Dygmalab/raise-left/(commit log)

2017-09-06 matrices done, keys started laying out
    [raise-left.sch, rgb-matrix.sch]
2017-09-06 everything placed on the board
    [raise-left.kicad_pcb]
2017-09-06 remove usb
    [raise-left.sch]
2017-09-07 ready for integrated huble
    [raise-left.kicad_pcb, raise-left.sch]
2017-09-08 pre routing
    [raise-left.kicad_pcb, raise-left.sch]
2017-09-08 routed with leds
    [raise-left.kicad_pcb, raise-left.sch]
2017-09-08 proper outline, ready for fab
    [raise-left.kicad_pcb]
2017-09-08 sent to fab
    [raise-left.kicad_pcb]
2017-10-01 fix component values
    [raise-left.sch]
2017-10-01 fix polygon fills
    [raise-left.kicad_pcb]
2017-10-03 pre LED delete
    [palmled.sch, raise-left.sch]
2017-10-03 pre led layout
    [raise-left.kicad_pcb, raise-left.sch]
2017-10-03 led layout, pre routing
    [raise-left.kicad_pcb, raise-left.sch]
2017-10-04 led footprints
    [raise-left.kicad_pcb]
2017-10-04 new led footprint
    [raise-left.kicad_pcb, raise-left.sch]
2017-10-07 lp led pins done, excess leds removed
    [raise-left.kicad_pcb, raise-left.sch]
2017-10-07 led fp
2017-10-11 fab with 0.16 clearance
    [raise-left.kicad_pcb, raise-left.sch]
2017-10-13 component order codes
    [raise-left.kicad_pcb, raise-left.sch]
2017-11-07 v4.2 export
    [raise-left.kicad_pcb, raise-left.sch]
2017-11-15 farnell numbers
    [raise-left.sch]
2017-11-15 moved silk for cap
    [raise-left.kicad_pcb]
2017-12-11 silk screen led changes
    [raise-left.kicad_pcb]
2017-12-11 reduced size of 3528 top mount fp for better soldering
2017-12-15 3i DFM
    [raise-left.kicad_pcb, raise-left.sch]
2017-12-20 more holes and new outlines
    [raise-left.kicad_pcb, raise-left.sch]
2017-12-28 usb socket moved
    [raise-left.kicad_pcb, raise-left.sch]
2018-01-02 new footprints
2018-01-02 new footprint
    [ledmatrix.sch]
2018-03-20 full BOM info on parts
    [ledmatrix.sch, raise-left.kicad_pcb, raise-left.sch]
2018-04-05 changed fp name of sled and added the J to part number
    [ledmatrix.sch]
2018-04-05 fp change for sled - same fp different name
    [raise-left.kicad_pcb]
2018-04-19 v4.4 sent to fab
    [ledmatrix.sch, raise-left.kicad_pcb, raise-left.sch, rgb-matrix.sch]
2018-04-23 updated for 0603 components
    [ledmatrix.sch, raise-left.sch]
2018-04-23 use tqfp not qfn
    [raise-left.sch]
2018-04-24 text notes on leds
    [ledmatrix.sch]
2018-04-24 fixed tiny part number and sheet refs
    [raise-left.sch]
2018-04-24 text change due to 5.1k r
    [raise-left.kicad_pcb]
2018-04-27 fixed ground connects on lp header, fixed broken led matrix commit that broke after 742cc9402ce5b39b1cbca2d424f676ff977e25d4
    [ledmatrix.sch, raise-left.kicad_pcb]
2018-05-02 ansi/iso work in progress
    [ledmatrix.sch, raise-left.kicad_pcb, raise-left.sch]
2018-05-02 usbc connector
2018-05-21 use local footprints
    [ledmatrix.sch, raise-left.kicad_pcb, raise-left.sch, rgb-matrix.sch]
2018-05-21 submodules for footprints and symbols
2018-05-24 iso/ansi start layout
    [ledmatrix.sch, raise-left.kicad_pcb, raise-left.sch]
2018-05-25 switch and led renumbered
    [ledmatrix.sch, raise-left.kicad_pcb, raise-left.sch]
2018-05-30 3d export for leds
    [raise-left.kicad_pcb]
2018-05-30 led iso/ansi numbering
    [ledmatrix.sch, raise-left.sch]
2018-06-07 post align
    [ledmatrix.sch, raise-left.kicad_pcb, raise-left.sch]
2018-06-07 diode moved
    [raise-left.kicad_pcb]
2018-06-07 fixed ansi/iso connection
    [raise-left.kicad_pcb, raise-left.sch]
2018-06-20 new alignment
    [ledmatrix.sch, raise-left.kicad_pcb, raise-left.sch]
2018-06-27 iso/ansi component naming
    [ledmatrix.sch, raise-left.kicad_pcb, raise-left.sch]
2018-06-28 pre autoroute
    [ledmatrix.sch, raise-left.kicad_pcb]
2018-06-28 led footprint with +
    [raise-left.kicad_pcb]
2018-06-28 routed after led pinout change
    [raise-left.kicad_pcb]
2018-06-29 ansi/iso bom
    [ledmatrix.sch, raise-left.kicad_pcb, raise-left.sch]
2018-07-03 moved led position and fixed sled fp name
    [ledmatrix.sch, raise-left.kicad_pcb]
2018-07-23 updated dates and titles on sheets
    [ledmatrix.sch, raise-left.sch]
2018-07-25 fixes for gp
    [raise-left.kicad_pcb, raise-left.sch]
2018-07-26 flipped components for proper position file export
    [raise-left.kicad_pcb]
2018-08-15 fixed i2c addr pulldown, better gnd on sled1735, avcc ref
    [raise-left.kicad_pcb, raise-left.sch]
2018-09-05 add inductor name to component value
    [raise-left.sch]
2018-09-05 changed 47uf ceramic to tantalum
    [ledmatrix.sch, raise-left.kicad_pcb, raise-left.sch]
2018-09-06 derated tantalum to 10v
    [ledmatrix.sch, raise-left.kicad_pcb]
2018-09-11 added extra led
    [ledmatrix.sch, raise-left.kicad_pcb, raise-left.sch]
2018-09-13 new outlines, new hole positions, moved softstart
    [raise-left.kicad_pcb]
2018-09-13 removed unused mount hole
    [raise-left.sch]
2018-09-13 final check before fab
    [raise-left.kicad_pcb]
2018-09-13 removed edge circles
    [raise-left.kicad_pcb]
2018-09-13 switched tantalum on schematic
    [ledmatrix.sch]
2018-09-18 changed to 2.2mm mount holes
    [raise-left.kicad_pcb, raise-left.sch]
2018-11-15 remove lib
    [ledmatrix.sch]
2018-11-15 100pf on input, testpoints for switches
    [raise-left.sch]
2018-11-15 rotate lp connector
    [raise-left.kicad_pcb]
2018-12-13 holes to 4mm, sled testpoints, usbC mask on locator points, diode and cap fp improvements
    [raise-left.kicad_pcb, raise-left.sch]
2018-12-13 added version without annotated component
    [raise-left.sch]
2018-12-13 fixed track over led hole
    [raise-left.kicad_pcb]
2018-12-13 usb C socket change to circular mask
    [raise-left.kicad_pcb]
2018-12-14 add extra ground plane for usbC socket security, label col/row testpoints
    [raise-left.kicad_pcb]
2018-12-17 added big pads for USBC
    [raise-left.kicad_pcb]
2018-12-21 SMT attribute: usb C change to SMD, DNP resistor and logo change to virtual
    [raise-left.kicad_pcb]
2018-12-21 change fiducial to SMD type
    [raise-left.kicad_pcb]
2019-01-14 add pin 1 refs to ics
    [raise-left.kicad_pcb]
2019-02-01 increase hole size and add keepouts for all leds cutouts
    [raise-left.kicad_pcb]
2019-02-11 add c6 silk testpoint
    [raise-left.kicad_pcb]
2019-02-12 added esd protection to sda/scl/reset/cc
    [ledmatrix.sch, raise-left.kicad_pcb, raise-left.sch]
2019-02-27 part numbers
    [ledmatrix.sch, raise-left.sch]
2019-03-06 new layout with more consideration for EMC
    [raise-left.kicad_pcb]
2019-03-07 schematic wasnt added somehow
    [ledmatrix.sch, raise-left.kicad_pcb, raise-left.sch]
2019-03-07 sled, tiny and power
    [ledmatrix.sch, raise-left.kicad_pcb, raise-left.sch]
2019-03-07 moved spi header
    [raise-left.kicad_pcb]
2019-03-07 moved shutdown r
    [ledmatrix.sch]
2019-03-07 wired cc and better grounding
    [raise-left.kicad_pcb]
2019-03-11 reset cap fix value to 10uf
    [raise-left.sch]
2019-03-11 qfn attiny in attiny lib
    [ledmatrix.sch, raise-left.sch]
2019-03-11 used tvs symbol
    [ledmatrix.sch, raise-left.sch]
2019-03-11 completed layout
    [raise-left.kicad_pcb]
2019-03-14 first layout attempts
    [ledmatrix.sch, raise-left.kicad_pcb, raise-left.sch]
2019-03-15 still to route: spi, filtered rows, i2c filtering
    [ledmatrix.sch, raise-left.kicad_pcb, raise-left.sch]
2019-03-15 all apart from spi
    [raise-left.kicad_pcb]
2019-03-15 finished layout
    [raise-left.kicad_pcb, raise-left.sch]
2019-03-15 ground stitch
    [raise-left.kicad_pcb]
2019-03-15 silkscreen and more ground stitching
    [raise-left.kicad_pcb]
2019-03-16 fixed some slot trace interferance - need bigger keepouts
    [raise-left.kicad_pcb]
2019-03-18 farnell values for new cap values
    [ledmatrix.sch, raise-left.sch]
2019-03-25 updated cap values, fixed mask on sled1735
    [ledmatrix.sch, raise-left.kicad_pcb, raise-left.sch]
2019-03-28 add asim part number for common mode choke
    [raise-left.sch]
2019-04-01 changed 1nf filter caps to DNP, and resister packs to 0R, updated schematic date
    [ledmatrix.sch, raise-left.sch]
2019-04-02 consolidate parts and farnell numbers
    [raise-left.kicad_pcb, raise-left.sch]
2019-04-02 fix sled fp
    [raise-left.kicad_pcb]
2019-04-03 bom consolidation
    [ledmatrix.sch, raise-left.sch]
2019-04-03 move test labels
    [raise-left.sch]
2019-04-03 spaced out test pads to avoid collision on jig board
    [raise-left.kicad_pcb]
2019-04-04 updated all testpoint values
    [raise-left.kicad_pcb, raise-left.sch]
2019-04-08 fixed tracks outside board edge
    [raise-left.kicad_pcb]
2019-04-18 fixed wrong DNP 0R resistors
    [ledmatrix.sch, raise-left.sch]
2019-04-23 fix 0R names, set filter caps to virtual in PCB
    [ledmatrix.sch, raise-left.kicad_pcb, raise-left.sch]
2019-06-20 updated reverse mounted led footprint and keepout
    [raise-left.kicad_pcb]
2019-06-20 added git version to top side
    [raise-left.kicad_pcb]
2019-07-05 datasheet for pmos
    [raise-left.sch]
2019-07-05 fix wrongly labelled test pads
    [raise-left.kicad_pcb]
2019-07-22 added names to copper fill
    [raise-left.kicad_pcb]
2019-07-24 kailh socket holes increased from 3 to 3.05mm
    [raise-left.kicad_pcb]
2019-12-19 update 3d models
    [raise-left.kicad_pcb]
